echamman/Ouroboros/Documentation/Pictures/DEV/Photos-001(4)/PXL_20250204_204302508.MP.jpg

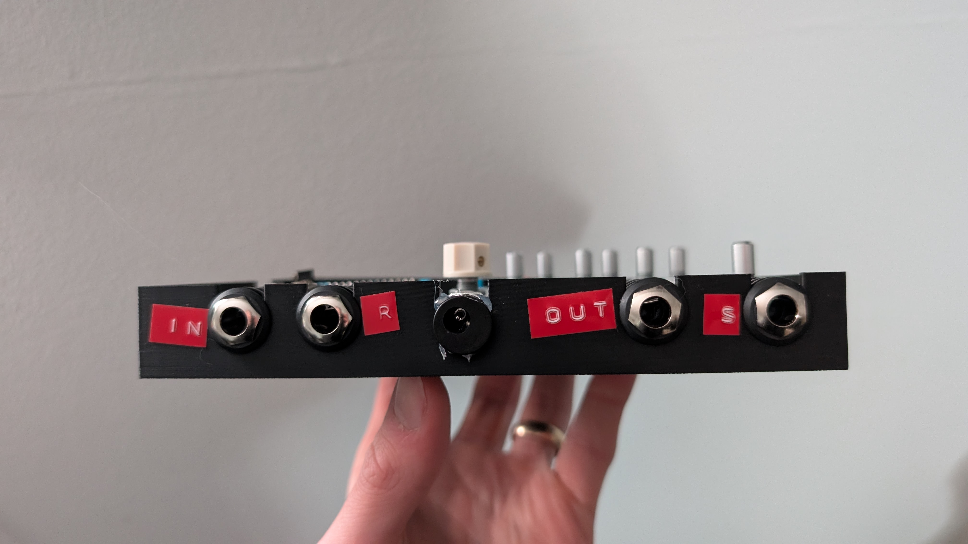
Documentation/Pictures/DEV/Photos-001(4)/PXL_20250204_204302508.MP.jpg
