echamman/Ouroboros/Documentation/Pictures/DEV/Photos-001(4)/2025_0204_12482400.jpg

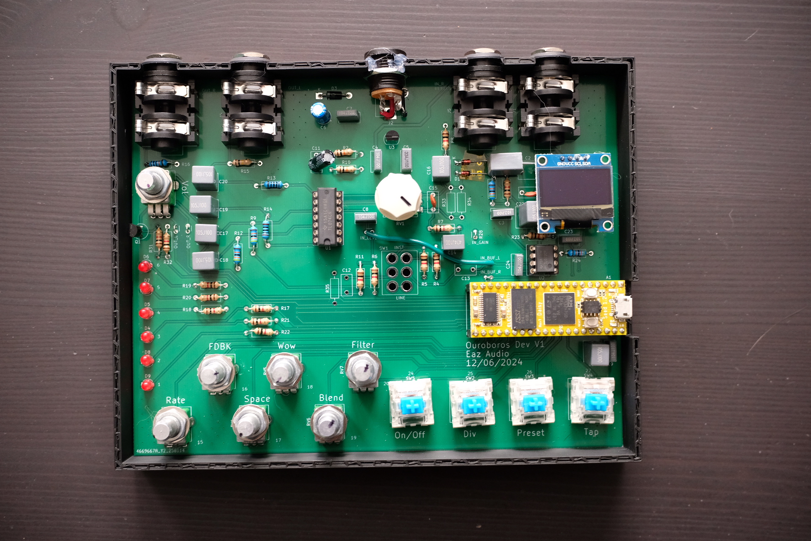
Documentation/Pictures/DEV/Photos-001(4)/2025_0204_12482400.jpg
