echamman/Ouroboros/README.md

Ouroboros is a fuzzy delay and reverb based on the Daisy Seed
