echamman/Ouroboros/Code/v1/README.md

# Ouroboros V1

## Author

Ethan

## Description

The breadboard circuit of Ouroboros
