echamman/Ouroboros/KiCad/Ouroboros/Ouroboros.kicad_pcb

## KiCad design KiCad/Ouroboros/Ouroboros.kicad_pcb (2025-01-14)

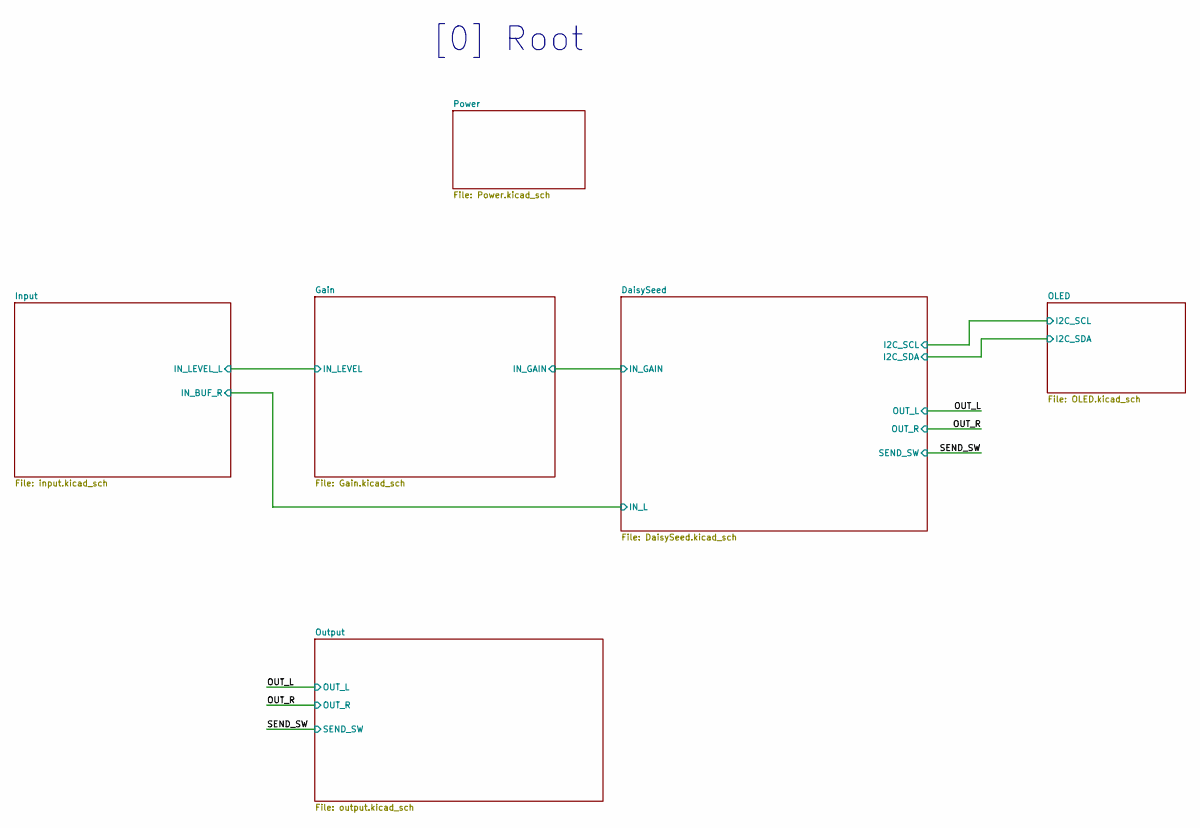
[picture p6: schematic Ouroboros.kicad_sch]

Notes on the sheet:
[0] Root

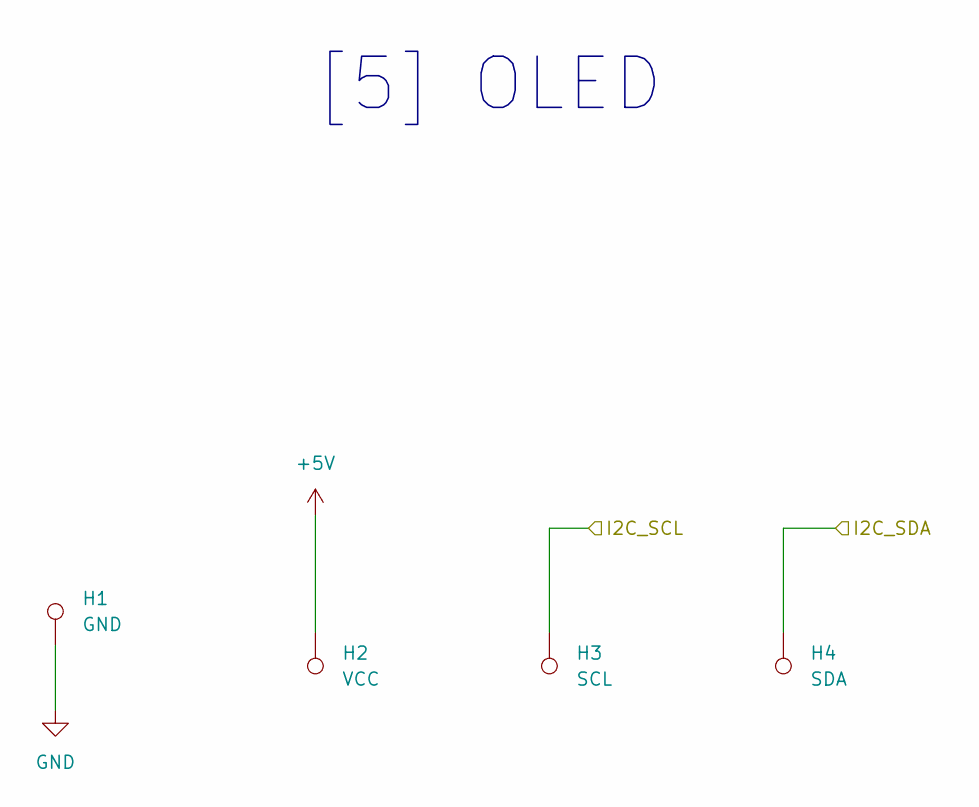
[picture p7: schematic OLED.kicad_sch]

Parts:
H1: GND; TestPoint_THTPad_D1.5mm_Drill0.7mm
H2: VCC; TestPoint_THTPad_D1.5mm_Drill0.7mm
H3: SCL; TestPoint_THTPad_D1.5mm_Drill0.7mm
H4: SDA; TestPoint_THTPad_D1.5mm_Drill0.7mm

Connections:
+5V: H2.1; also elsewhere on the board
/DaisySeed/I2C_SCL: H3.1; also elsewhere on the board
/DaisySeed/I2C_SDA: H4.1; also elsewhere on the board
GND: H1.1; also elsewhere on the board

Notes on the sheet:
[5] OLED

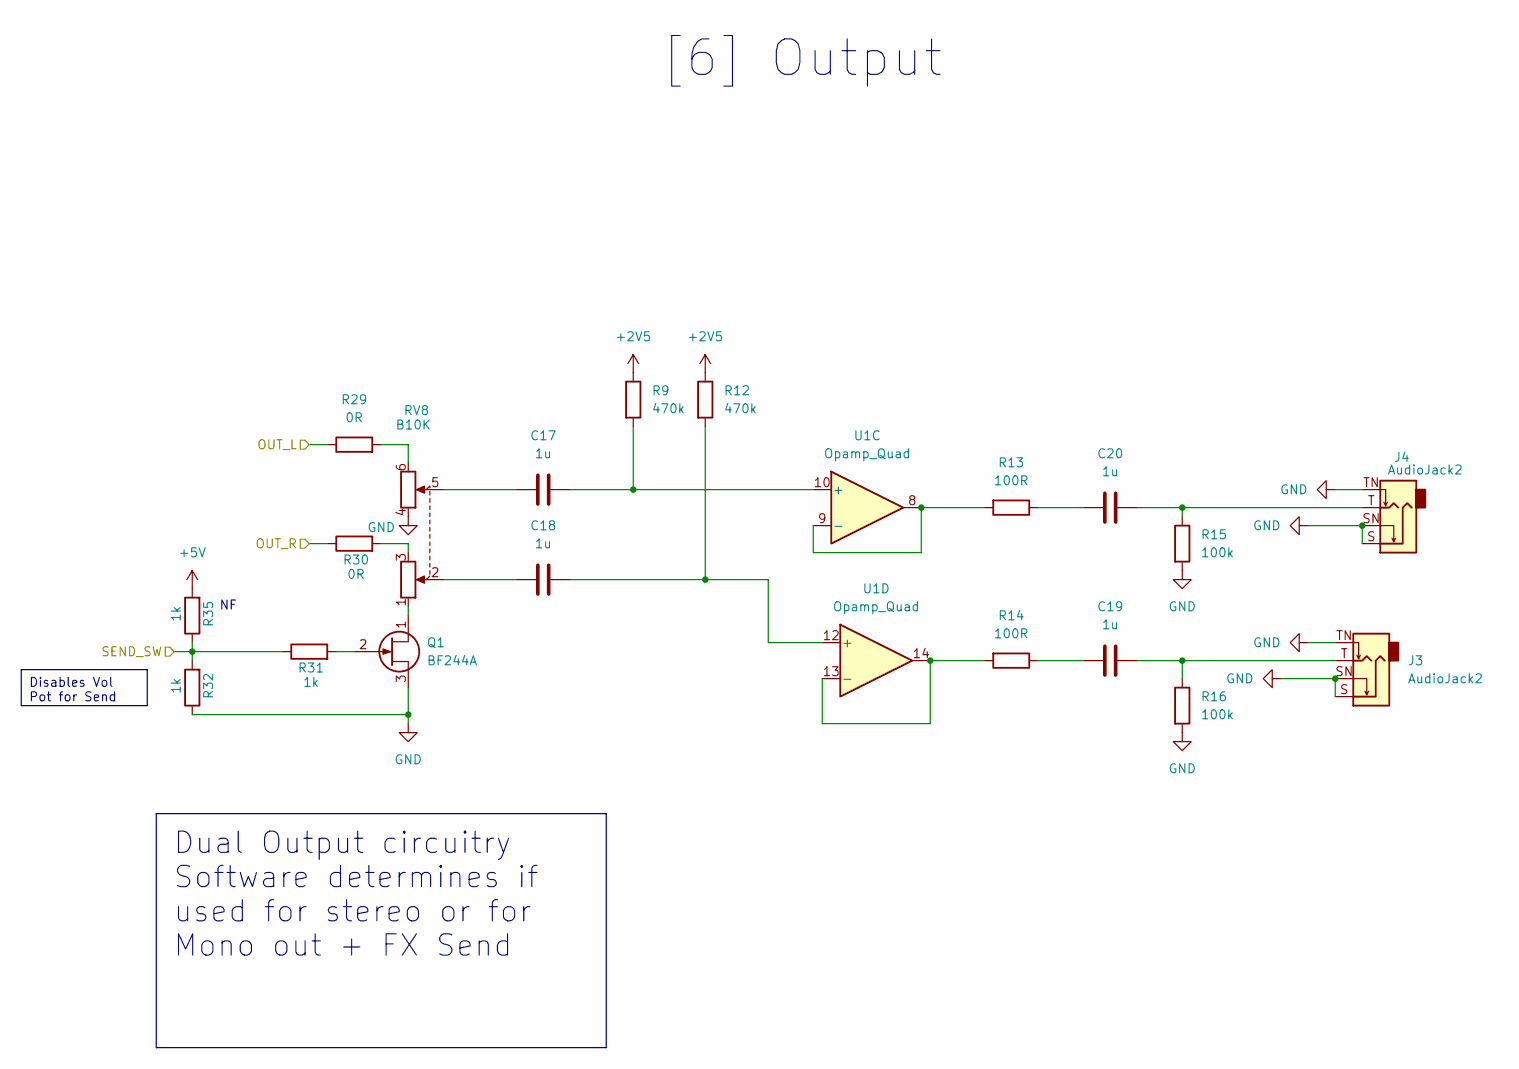
[picture p8: schematic output.kicad_sch]

Parts:
C17, C18, C19, C20: 1u; C_Rect_L7.0mm_W6.0mm_P5.00mm
J3, J4: AudioJack2; Jack_6.35mm_Neutrik_NMJ4HFD2_Horizontal
Q1: BF244A; TO-92_Inline
R9, R12: 470k; R_Axial_DIN0207_L6.3mm_D2.5mm_P10.16mm_Horizontal
R13, R14: 100R; R_Axial_DIN0207_L6.3mm_D2.5mm_P10.16mm_Horizontal
R15, R16: 100k; R_Axial_DIN0207_L6.3mm_D2.5mm_P10.16mm_Horizontal
R29, R30: 0R; R_Axial_DIN0204_L3.6mm_D1.6mm_P1.90mm_Vertical
R31, R32, R35: 1k; R_Axial_DIN0207_L6.3mm_D2.5mm_P10.16mm_Horizontal
RV8: B10K; Potentiometer_Alpha_RD902F-40-00D_Dual_Vertical
U1: Opamp_Quad; DIP-14_W7.62mm_Socket

Connections:
+2V5: R9.1, R12.1; also elsewhere on the board
+5V: R35.2; also elsewhere on the board
/OUT_L: R29.1; also elsewhere on the board
/OUT_R: R30.1; also elsewhere on the board
/SEND_SW: R31.1, R32.2, R35.1; also elsewhere on the board
GND: J3.S, J3.SN, J3.TN, J4.S, J4.SN, J4.TN, Q1.3 (S), R15.2, R16.2, R32.1, RV8.4; also elsewhere on the board
unnamed: C17.1, RV8.5
unnamed: C18.1, RV8.2
unnamed: C19.1, R14.1
unnamed: C19.2, J3.T, R16.1
unnamed: C20.1, R13.1
unnamed: C20.2, J4.T, R15.1
unnamed: Q1.1 (D), RV8.1
unnamed: Q1.2 (G), R31.2
unnamed: R29.2, RV8.6
unnamed: R30.2, RV8.3
unnamed: C17.2, R9.2, U1.10 (+)
unnamed: R13.2, U1.8, U1.9 (-)
unnamed: C18.2, R12.2, U1.12 (+)
unnamed: R14.2, U1.13 (-), U1.14

Notes on the sheet:
Disables Vol Pot for Send
Dual Output circuitry Software determines if used for stereo or for Mono out + FX Send
[6] Output

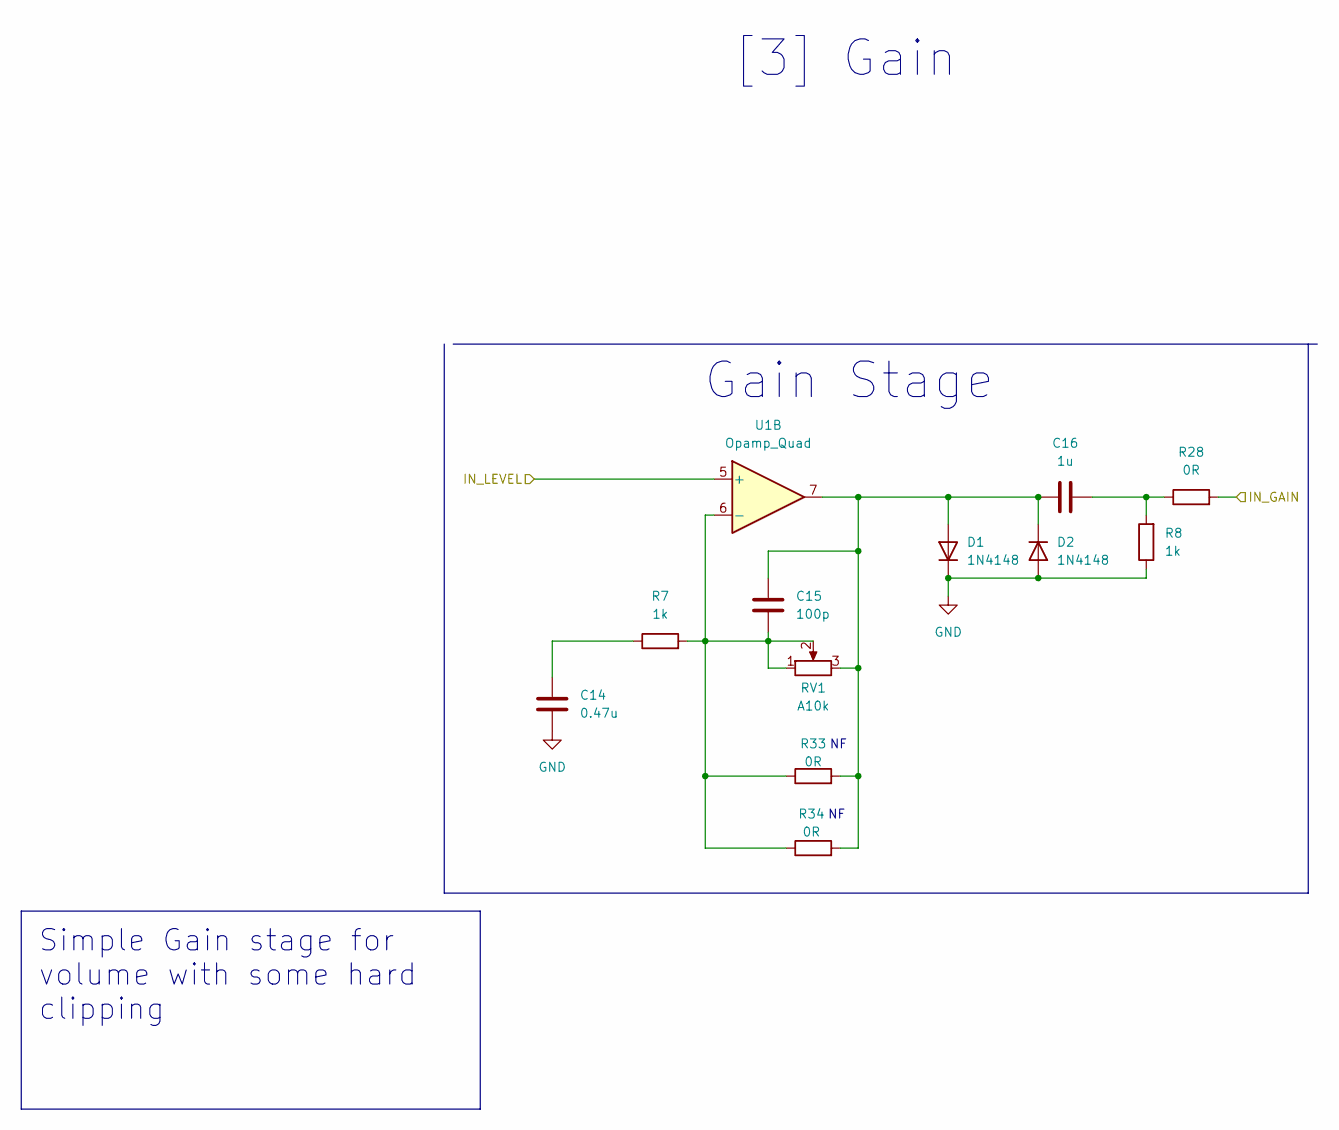
[picture p9: schematic Gain.kicad_sch]

Parts:
C14: 0.47u; C_Rect_L7.0mm_W3.5mm_P5.00mm
C15: 100p; C_Rect_L7.0mm_W3.5mm_P5.00mm
C16: 1u; C_Rect_L7.0mm_W6.0mm_P5.00mm
D1, D2: 1N4148; D_DO-35_SOD27_P7.62mm_Horizontal
R7, R8: 1k; R_Axial_DIN0207_L6.3mm_D2.5mm_P10.16mm_Horizontal
R28: 0R; R_Axial_DIN0204_L3.6mm_D1.6mm_P1.90mm_Vertical
R33, R34: 0R; R_Axial_DIN0207_L6.3mm_D2.5mm_P10.16mm_Horizontal
RV1: A10k; Potentiometer_Alpha_RD901F-40-00D_Single_Vertical
U1: Opamp_Quad; DIP-14_W7.62mm_Socket

Connections:
/DaisySeed/IN_GAIN: R28.2; also elsewhere on the board
/Gain/IN_LEVEL: U1.5 (+); also elsewhere on the board
GND: C14.2, D1.1 (K), D2.2 (A), R8.1; also elsewhere on the board
unnamed: C14.1, R7.1
unnamed: C16.2, R8.2, R28.1
unnamed: C15.1, C16.1, D1.2 (A), D2.1 (K), R33.2, R34.2, RV1.3, U1.7
unnamed: C15.2, R7.2, R33.1, R34.1, RV1.1, RV1.2, U1.6 (-)

Notes on the sheet:
Simple Gain stage for volume with some hard clipping
Gain Stage
[3] Gain

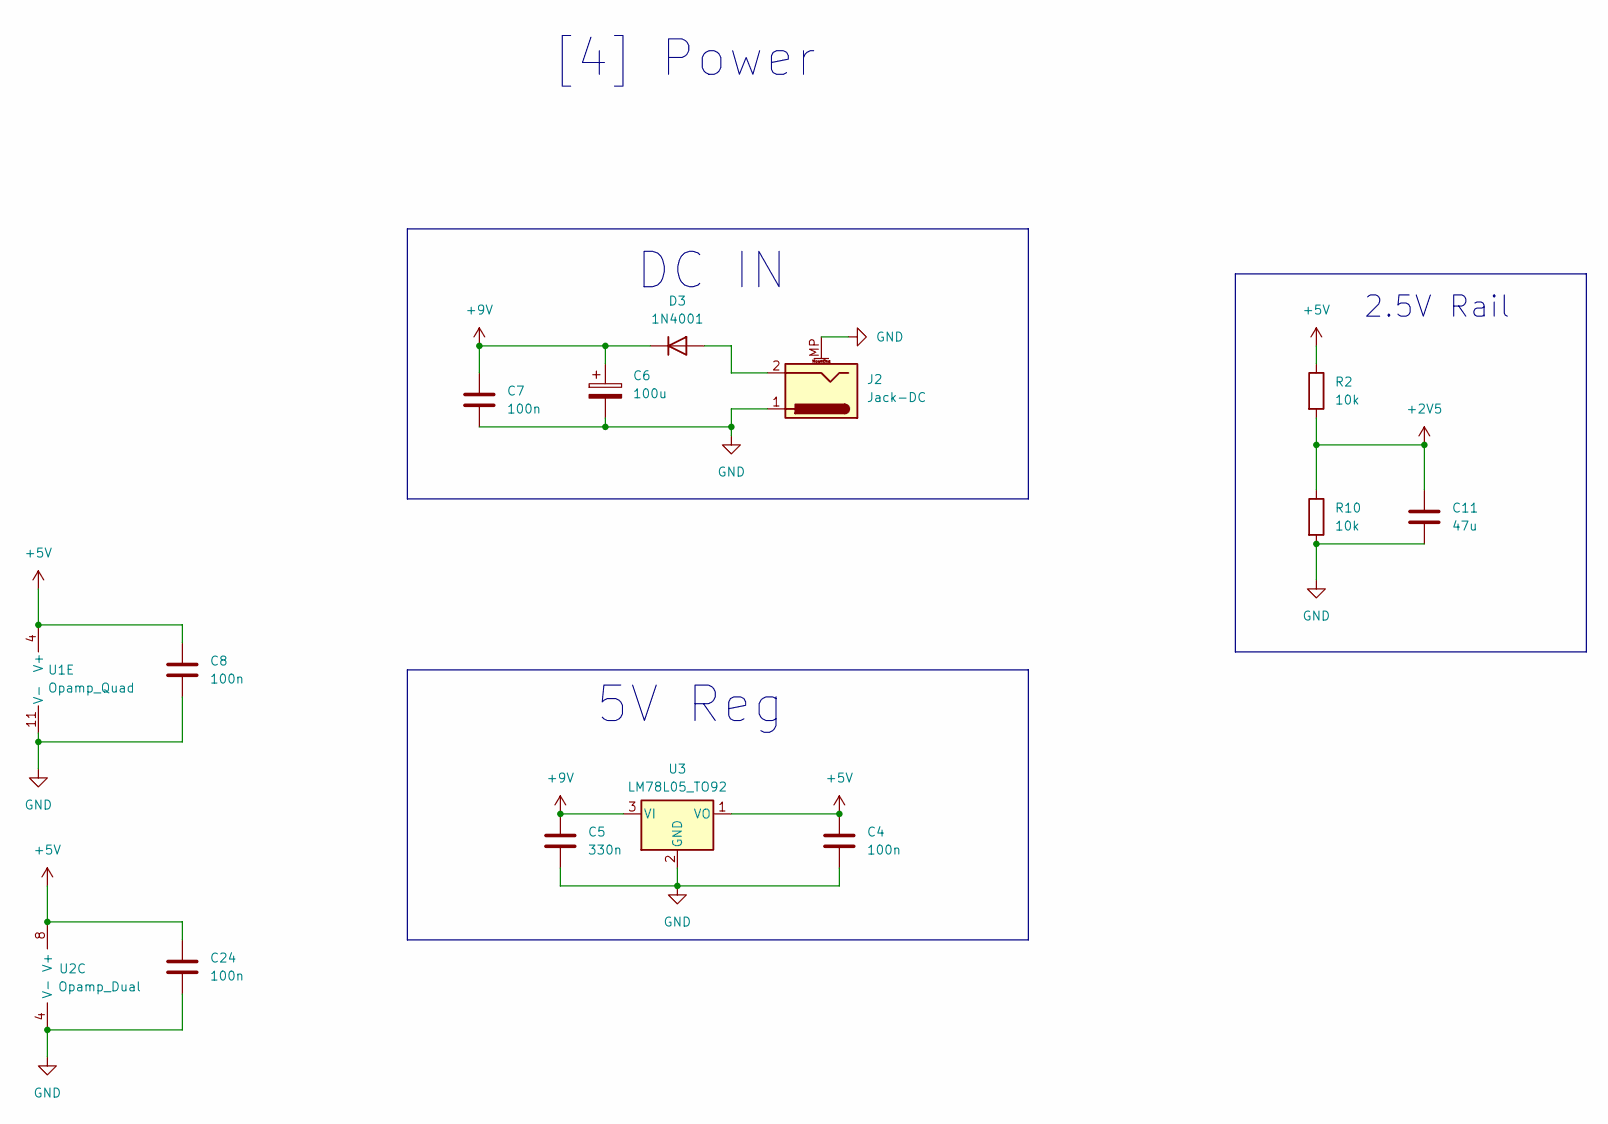
[picture p10: schematic Power.kicad_sch]

Parts:
C4, C7, C8, C24: 100n; C_Rect_L7.0mm_W3.5mm_P5.00mm
C5: 330n; C_Rect_L7.0mm_W3.5mm_P5.00mm
C6: 100u; CP_Radial_D5.0mm_P2.50mm
C11: 47u; C_Rect_L7.0mm_W3.5mm_P5.00mm
D3: 1N4001; D_DO-41_SOD81_P10.16mm_Horizontal
J2: Jack-DC; BarrelJack_CUI_PJ-063AH_Horizontal_CircularHoles
R2, R10: 10k; R_Axial_DIN0207_L6.3mm_D2.5mm_P10.16mm_Horizontal
U1: Opamp_Quad; DIP-14_W7.62mm_Socket
U2: Opamp_Dual; DIP-8_W7.62mm_Socket
U3: LM78L05_TO92; TO-92_Inline

Connections:
+2V5: C11.1, R2.2, R10.1; also elsewhere on the board
+5V: C4.1, C8.1, C24.1, R2.1, U1.4 (V+), U2.8 (V+), U3.1 (VO); also elsewhere on the board
+9V: C5.1, C6.1, C7.1, D3.1 (K), U3.3 (VI); also elsewhere on the board
GND: C4.2, C5.2, C6.2, C7.2, C8.2, C11.2, C24.2, J2.1, J2.MP (MountPin), R10.2, U1.11 (V-), U2.4 (V-), U3.2 (GND); also elsewhere on the board
unnamed: D3.2 (A), J2.2

Notes on the sheet:
DC IN
[4] Power
5V Reg
2.5V Rail

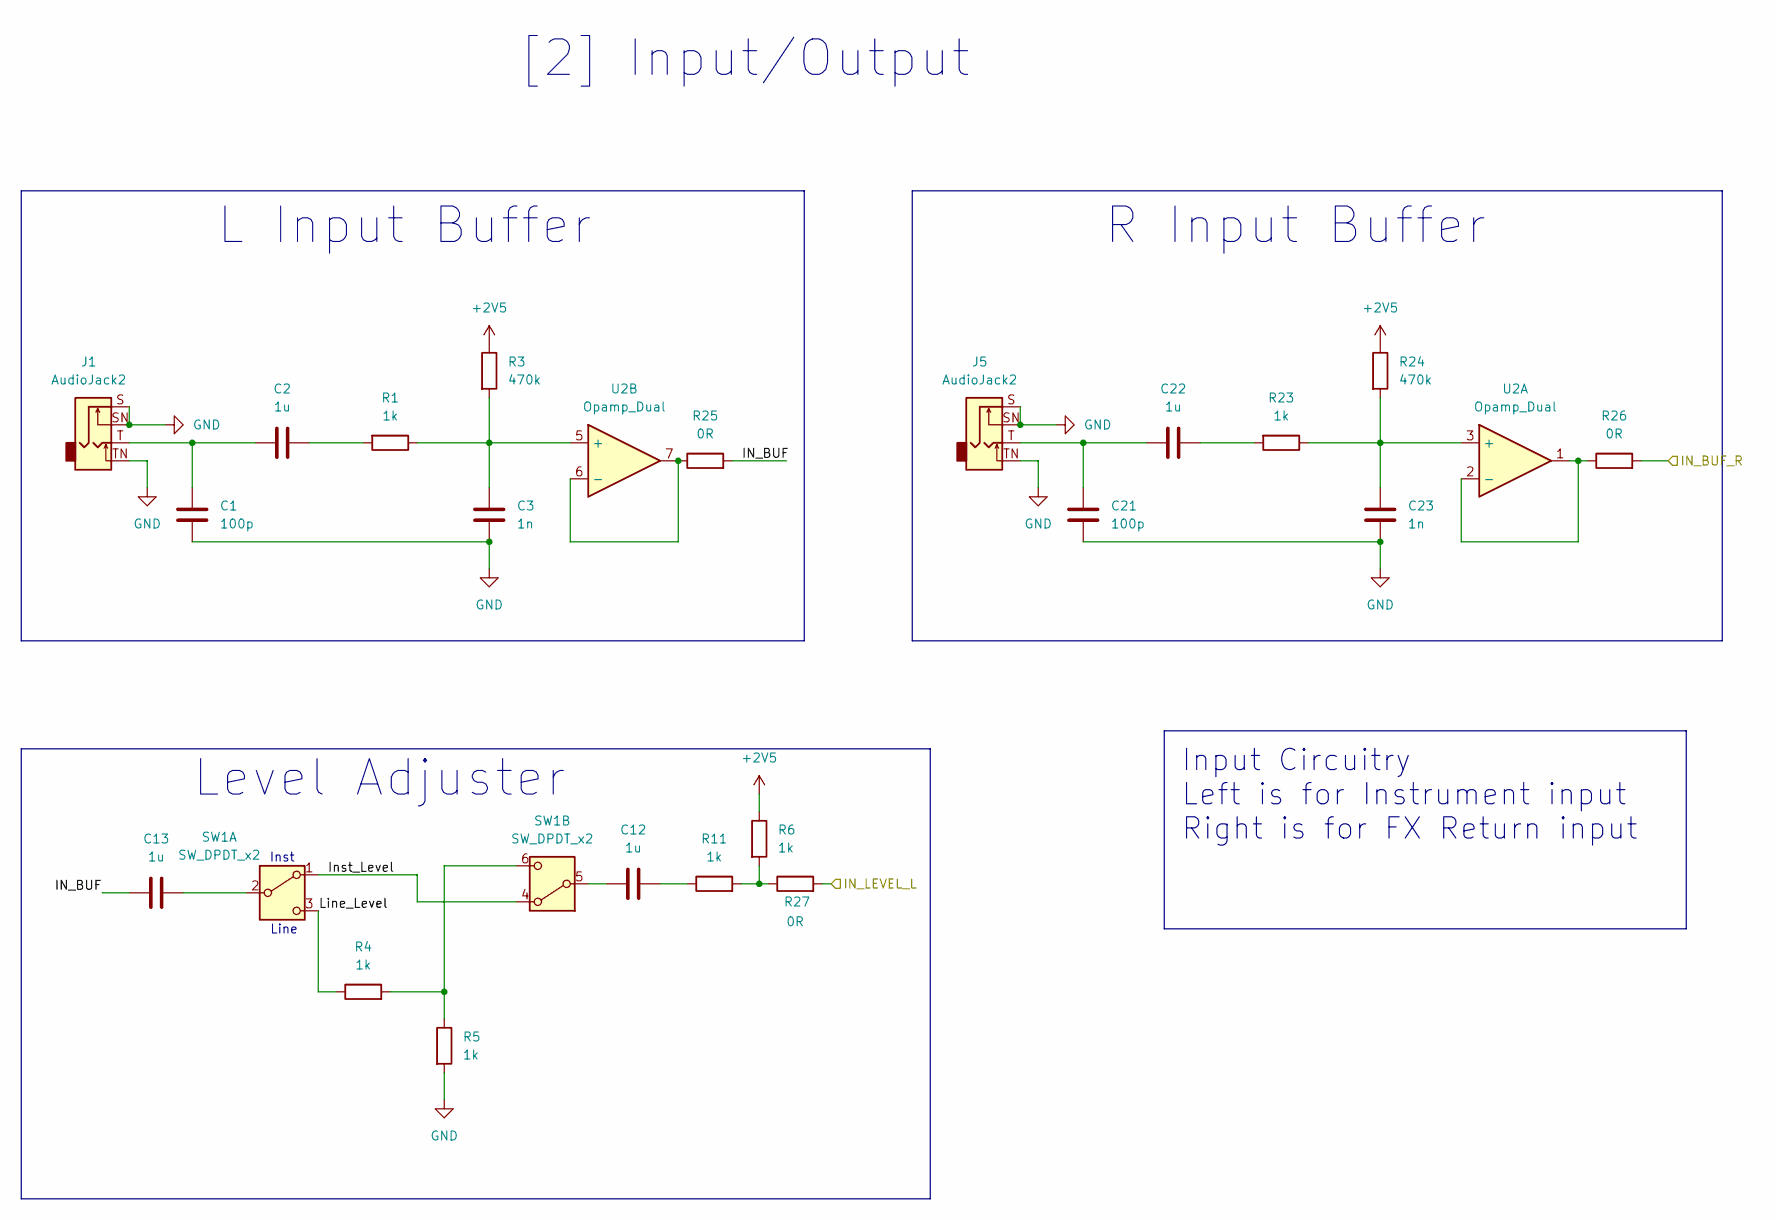
[picture p11: schematic input.kicad_sch]

Parts:
C1, C21: 100p; C_Rect_L7.0mm_W3.5mm_P5.00mm
C2, C22: 1u; C_Rect_L7.0mm_W6.0mm_P5.00mm
C3, C23: 1n; C_Rect_L7.0mm_W3.5mm_P5.00mm
C12, C13: 1u; C_Rect_L7.0mm_W3.5mm_P5.00mm
J1, J5: AudioJack2; Jack_6.35mm_Neutrik_NMJ4HFD2_Horizontal
R1, R4, R5, R6, R11, R23: 1k; R_Axial_DIN0207_L6.3mm_D2.5mm_P10.16mm_Horizontal
R3, R24: 470k; R_Axial_DIN0207_L6.3mm_D2.5mm_P10.16mm_Horizontal
R25, R26, R27: 0R; R_Axial_DIN0204_L3.6mm_D1.6mm_P1.90mm_Vertical
SW1: SW_DPDT_x2; DPDT_Mini_Toggle
U2: Opamp_Dual; DIP-8_W7.62mm_Socket

Connections:
+2V5: R3.1, R6.1, R24.1; also elsewhere on the board
/DaisySeed/IN_L: R26.2; also elsewhere on the board
/Gain/IN_LEVEL: R27.2; also elsewhere on the board
/Input/IN_BUF: C13.1, R25.2
/Input/Inst_Level: SW1.1 (A), SW1.4 (A)
/Input/Line_Level: R4.1, SW1.3 (C)
GND: C1.2, C3.2, C21.2, C23.2, J1.S, J1.SN, J1.TN, J5.S, J5.SN, J5.TN, R5.2; also elsewhere on the board
unnamed: C1.1, C2.1, J1.T
unnamed: C2.2, R1.2
unnamed: C12.2, R11.1
unnamed: C21.1, C22.1, J5.T
unnamed: C22.2, R23.2
unnamed: R6.2, R11.2, R27.1
unnamed: C13.2, SW1.2 (B)
unnamed: C12.1, SW1.5 (B)
unnamed: R4.2, R5.1, SW1.6 (C)
unnamed: C23.1, R23.1, R24.2, U2.3 (+)
unnamed: R26.1, U2.1, U2.2 (-)
unnamed: C3.1, R1.1, R3.2, U2.5 (+)
unnamed: R25.1, U2.6 (-), U2.7

Notes on the sheet:
Input Circuitry Left is for Instrument input Right is for FX Return input
L Input Buffer
Level Adjuster
R Input Buffer
Inst
Line
[2] Input/Output

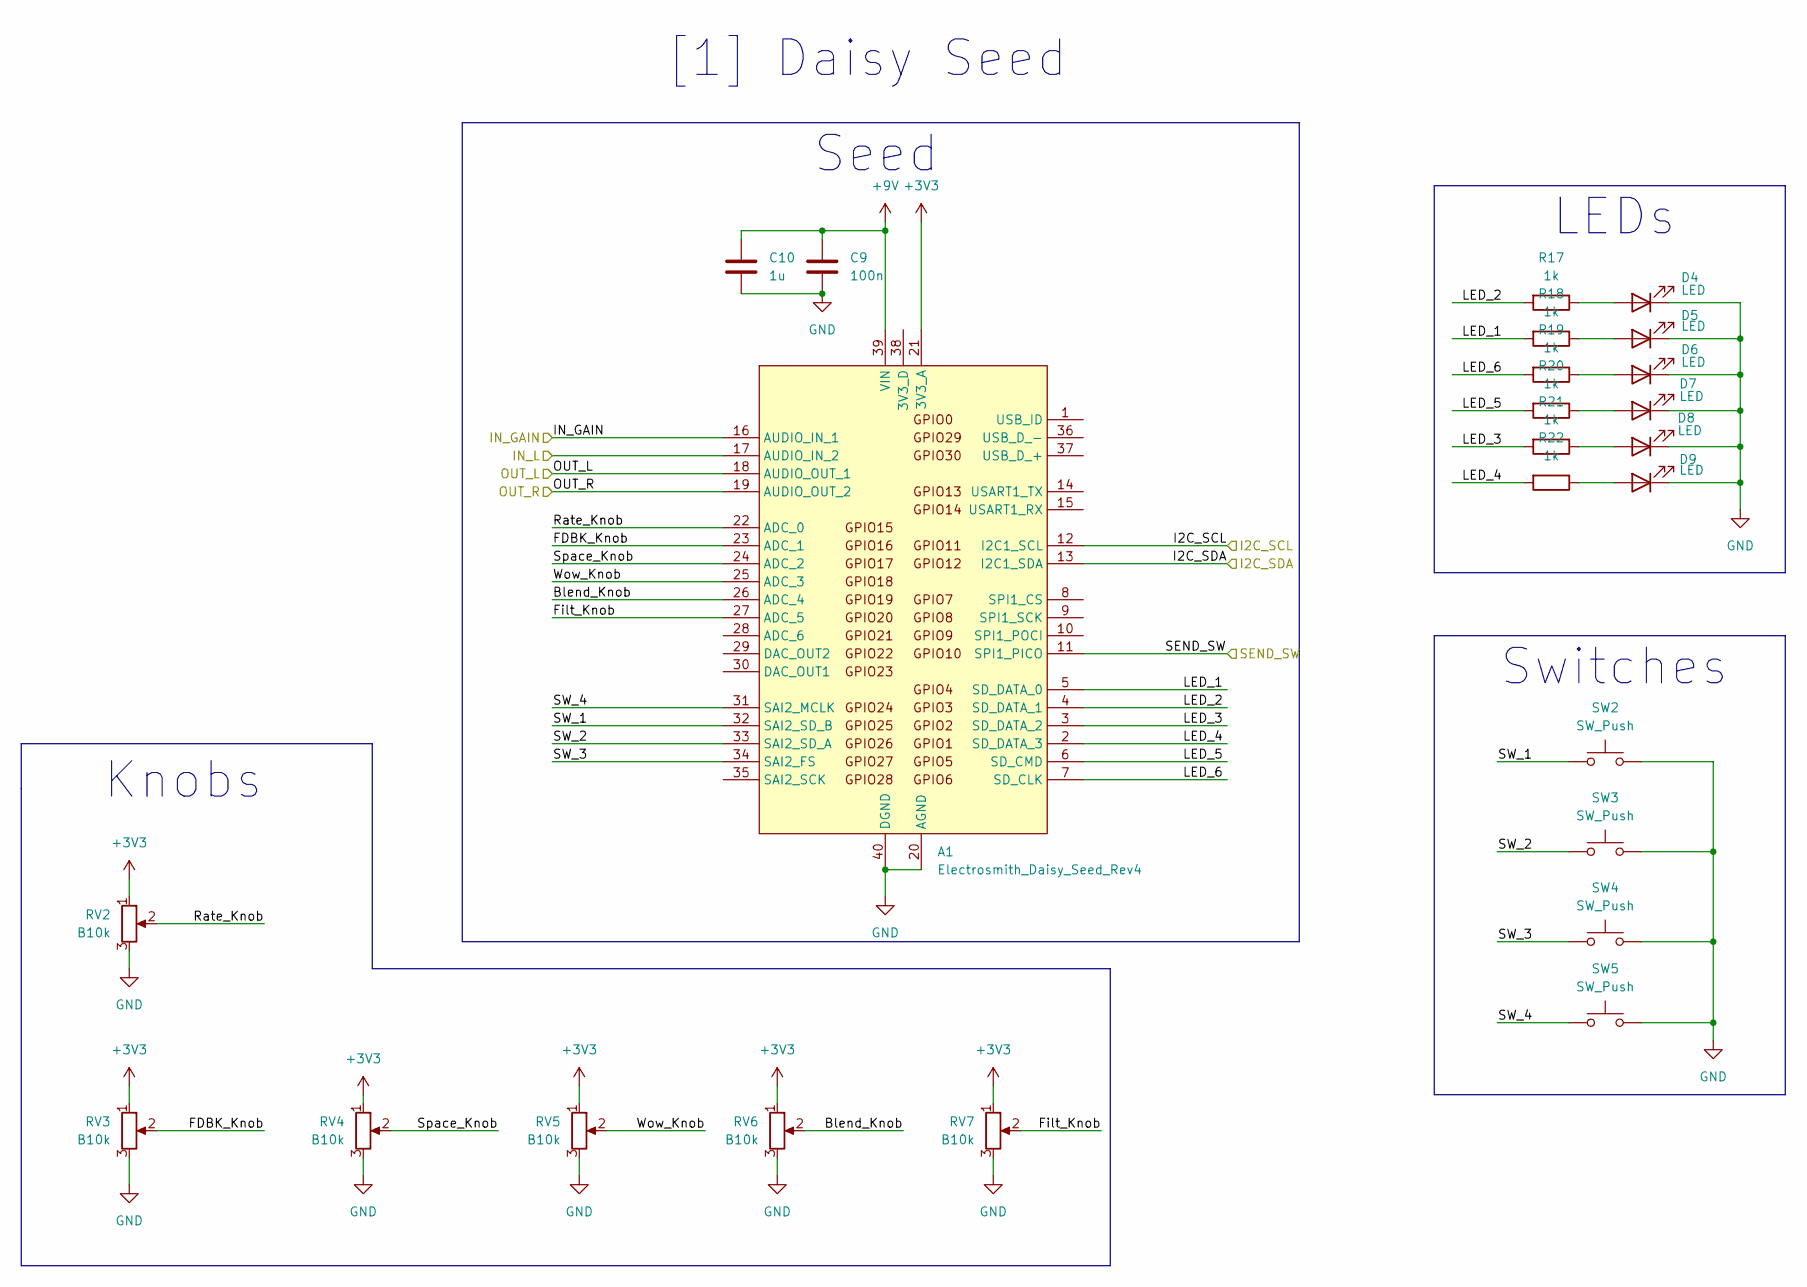
[picture p12: schematic DaisySeed.kicad_sch]

Parts:
A1: Electrosmith_Daisy_Seed_Rev4; Electrosmith_Daisy_Seed
C9: 100n; C_Rect_L7.0mm_W3.5mm_P5.00mm
C10: 1u; C_Rect_L7.0mm_W6.0mm_P5.00mm
D4, D5, D6, D7, D8, D9: LED; LED_D3.0mm
R17, R18, R19, R20, R21, R22: 1k; R_Axial_DIN0207_L6.3mm_D2.5mm_P10.16mm_Horizontal
RV2, RV3, RV4, RV5, RV6, RV7: B10k; Potentiometer_Alpha_RD901F-40-00D_Single_Vertical
SW2, SW3, SW4, SW5: SW_Push; SW_Cherry_MX_1.00u_PCB

Connections:
+3V3: A1.21 (3V3_A), RV2.1, RV3.1, RV4.1, RV5.1, RV6.1, RV7.1
+9V: A1.39 (VIN), C9.1, C10.1; also elsewhere on the board
/DaisySeed/Blend_Knob: A1.26 (ADC_4), RV6.2
/DaisySeed/FDBK_Knob: A1.23 (ADC_1), RV3.2
/DaisySeed/Filt_Knob: A1.27 (ADC_5), RV7.2
/DaisySeed/I2C_SCL: A1.12 (I2C1_SCL); also elsewhere on the board
/DaisySeed/I2C_SDA: A1.13 (I2C1_SDA); also elsewhere on the board
/DaisySeed/IN_GAIN: A1.16 (AUDIO_IN_1); also elsewhere on the board
/DaisySeed/IN_L: A1.17 (AUDIO_IN_2); also elsewhere on the board
/DaisySeed/LED_1: A1.5 (SD_DATA_0), R18.2
/DaisySeed/LED_2: A1.4 (SD_DATA_1), R17.2
/DaisySeed/LED_3: A1.3 (SD_DATA_2), R21.2
/DaisySeed/LED_4: A1.2 (SD_DATA_3), R22.2
/DaisySeed/LED_5: A1.6 (SD_CMD), R20.2
/DaisySeed/LED_6: A1.7 (SD_CLK), R19.2
/DaisySeed/Rate_Knob: A1.22 (ADC_0), RV2.2
/DaisySeed/SW_1: A1.32 (SAI2_SD_B), SW2.1
/DaisySeed/SW_2: A1.33 (SAI2_SD_A), SW3.1
/DaisySeed/SW_3: A1.34 (SAI2_FS), SW4.1
/DaisySeed/SW_4: A1.31 (SAI2_MCLK), SW5.1
/DaisySeed/Space_Knob: A1.24 (ADC_2), RV4.2
/DaisySeed/Wow_Knob: A1.25 (ADC_3), RV5.2
/OUT_L: A1.18 (AUDIO_OUT_1); also elsewhere on the board
/OUT_R: A1.19 (AUDIO_OUT_2); also elsewhere on the board
/SEND_SW: A1.11 (SPI1_PICO); also elsewhere on the board
GND: A1.20 (AGND), A1.40 (DGND), C9.2, C10.2, D4.1 (K), D5.1 (K), D6.1 (K), D7.1 (K), D8.1 (K), D9.1 (K), RV2.3, RV3.3, RV4.3, RV5.3, RV6.3, RV7.3, SW2.2, SW3.2, SW4.2, SW5.2; also elsewhere on the board
unnamed: D4.2 (A), R17.1
unnamed: D5.2 (A), R18.1
unnamed: D6.2 (A), R19.1
unnamed: D7.2 (A), R20.1
unnamed: D8.2 (A), R21.1
unnamed: D9.2 (A), R22.1

Notes on the sheet:
Seed
[1] Daisy Seed
Switches
Knobs
LEDs

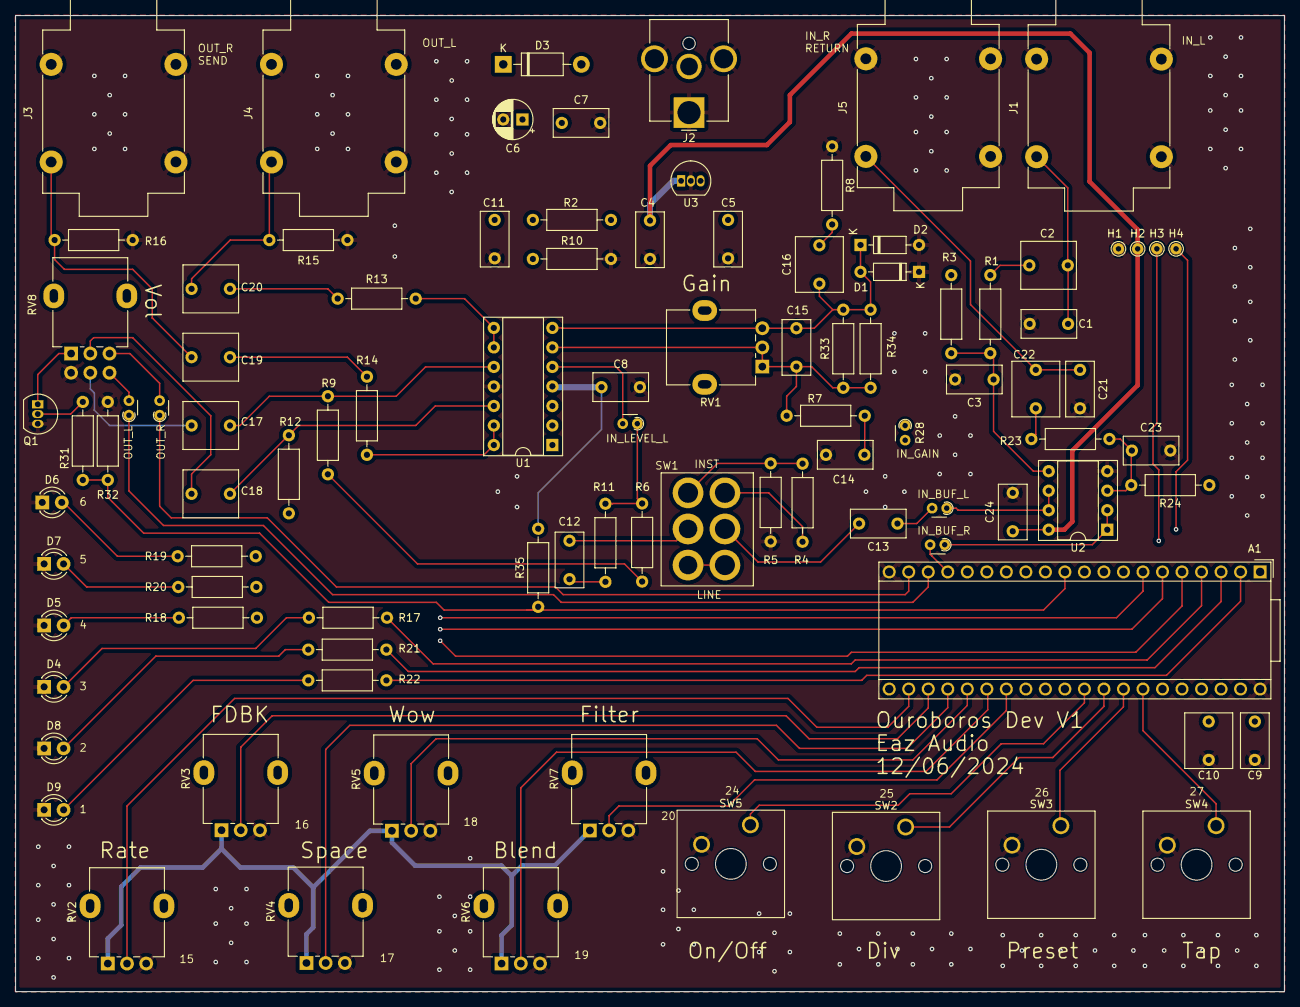
[picture p13: board Ouroboros.kicad_pcb from above]

Board: 4 copper layers, 165.1 x 127.0 mm, 95 parts (0 on the bottom side), 70 nets.
