echamman/Ouroboros/(commit log)

2024-10-28 Cleaning up
    [Daisy_Seed_Rev4_Pinout.csv, erase_f0xx.cfg, erase_f10x.cfg, erase_f37x.cfg, erase_f4xx.cfg, erase_h7xx.cfg]
2024-11-03 Optimizing knob readings to fix scratchiness
    [Ouroboros.cpp]
2024-11-09 Fixing metro and LED flash
    [Ouroboros.cpp]
2024-11-15 Adding KiCad
    [DaisySeed.kicad_sch, Gain.kicad_sch, Ouroboros.kicad_pcb, Ouroboros.kicad_sch, Power.kicad_sch, input.kicad_sch]
2024-11-15 Updating schematic
    [DaisySeed.kicad_sch, Gain.kicad_sch, Ouroboros.kicad_sch, Power.kicad_sch, input.kicad_sch]
2024-11-15 Linking nets
    [DaisySeed.kicad_sch, Gain.kicad_sch, Ouroboros.kicad_sch, Power.kicad_sch, input.kicad_sch]
2024-12-01 Updated schematic, started PCB
    [DaisySeed.kicad_sch, Gain.kicad_sch, Ouroboros.kicad_pcb, Power.kicad_sch, input.kicad_sch]
2024-12-07 PCB Finished
    [DaisySeed.kicad_sch, Gain.kicad_sch, OLED.kicad_sch, Ouroboros.kicad_pcb, Ouroboros.kicad_sch, Power.kicad_sch, output.kicad_sch, untitled.kicad_sch]
2025-01-14 Dev Board complete
    [DaisySeed.kicad_sch, Gain.kicad_sch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]
2025-01-22 Devboard V0.1 hardware mapping
    [OuroborosBOM.csv]
2025-01-23 Devboard V0.22 Added LP Filter
2025-01-23 Devboard V.23 Upgrade to LP + HP Filter
2025-01-24 Devboard V0.31 button logic updated
2025-01-24 Devboard V0.33 optimizing code to only run value updates when knob or button moved
2025-01-25 Devboard V0.34 fixed crackling when changing rate
    [Ouroboros.cpp, tempoManager.cpp, tempoManager.h]
2025-02-04 Temporary fix for delaytime preset management
    [Ouroboros.cpp, knobManager.cpp, knobManager.h, tempoManager.cpp, tempoManager.h]
